veis-lzf/DC-stabilized-voltage-source/readme.md

# 便携式USB直流稳压电源

## 参数简介

1. 电压输出范围：0V~10V
2. 额定功率：5V/300mA
3. 显示精度：±0.01V

## 备注

	（1）需要更大电流输出的，可更换更大体积的电感，把USB修改为Type-C接口，续流二极管D4和保险丝F1也需要根据实际情况调整，需要注意芯片layout时散热处理；
