veis-lzf/DC-stabilized-voltage-source/PCB/SMT/Vpwr_V1.2_BOM.xlsx

Design Name G:/Cadence Allegro/My_Prj/VarPower/PCB/Vpwr_v1_2.brd |  |  |  |  |  | 器件标注说明 | NC
Date Sat Aug 30 16:28:15 2020 |  |  |  |  |  |  | SMT
Vpwr_V1.2_BOM |  |  |  |  |  |  | 后焊
封装名称 | 器件具体型号 | 元器件值 | 器件类别 | 数量 | 位号 | 是否SMT
1_25_PWT_4P |  | Download | 贴片连接座 | 1 | J1
1_25_PWT_4P |  | UART1 | 贴片连接座 | 1 | J2
C0603 |  | 1uF/10V | 贴片电容 | 1 | C1
C0603 |  | 0.1uF/50V | 贴片电容 | 3 | C2,C4,C11
C0603 |  | 1uF/16V | 贴片电容 | 2 | C3,C5
C0603 |  | 0.01uF/50V | 贴片电容 | 1 | C12
CH5R08-2A |  | B2S | 直插连接座 | 1 | J3
C_SMD_10X10_3 |  | 470uF/25V | 贴片铝电解电容 | 1 | C9
FULSE1206 |  | 1A/16V | 贴片自恢复保险 | 1 | F1
LED-SEG-TH_SLR0283DBA1BD |  | SLR0283DBA1BD | 2.8英寸三位数码管 | 1 | DS1
R0603 |  | 10K | 贴片电阻 | 3 | R1,R14,R17
R0603 |  | 100R | 贴片电阻 | 9 | R2,R3,R4,R5,R6,R7,R8,R9,R20
R0603 |  | 191K/1% | 贴片电阻 | 1 | R10
R0603 |  | 100K | 贴片电阻 | 1 | R11
R0603 |  | 10K/1% | 贴片电阻 | 1 | R12
R0603 |  | 3K | 贴片电阻 | 3 | R13,R16,R18
R0603 |  | 3K/1% | 贴片电阻 | 1 | R15
R0603 |  | 1K/1% | 贴片电阻 | 1 | R19
R0603 |  | 200R | 贴片电阻 | 2 | R21,R22
RK09K |  | 10K | 旋钮式可调电阻 | 1 | VR1
SK-12D02-VG3 |  | SPDT-SW | 拨动开关 | 1 | SW1
SM3521 |  | 4.7uH | 贴片工字电感 | 1 | L1
SOD123 |  | SS14 | 贴片肖特基二极管 | 3 | D1,D4,D5
SOD123 |  | SS14/NC | 贴片肖特基二极管 | 1 | D2
SOD323 |  | MM3Z9V1/NC | 贴片稳压管 | 1 | D3
SOIC-8 |  | LM358 | 贴片双运放 | 1 | U4
SOT-23 |  | AO3401 | 贴片PMOS管 | 1 | Q2
SOT-23 |  | MMBT5551 | 贴片NPN三级管 | 1 | Q3
SOT-23 |  | TL431ACD | 2.49V基准源 | 1 | Q4
SOT-23 |  | SC662K-3.3V | LDO降压芯片 | 1 | U2
SOT-23-6 |  | SX1308 | 升压DCDC芯片 | 1 | U3
TA3216 |  | 22uF | 贴片钽电容 | 1 | C6
TA3216 |  | 22uF/25V | 贴片钽电容 | 3 | C7,C8,C10
TO252-132 |  | 2SB772-P | 贴片PNP功率三级管 | 1 | Q1
TP-40MIL-SMT |  | VUSB_IN | 测试点 | 1 | TP1
TP-40MIL-SMT |  | VUSB | 测试点 | 1 | TP2
TP-40MIL-SMT |  | VIN_12V | 测试点 | 1 | TP3
TP-40MIL-SMT |  | VIN | 测试点 | 1 | TP4
TP-40MIL-SMT |  | VOUT | 测试点 | 1 | TP5
TP-40MIL-SMT |  | TEST_POINT | 测试点 | 1 | TP6
TP-40MIL-SMT |  | FEEDBACK | 测试点 | 1 | TP7
TSSOP-20 |  | STM8S103F3P6 | 单片机 | 1 | U1
USB-A-M-DIP |  | USB_A | USB公头 | 1 | USB1
