veis-lzf/DC-stabilized-voltage-source/PCB/ASM/ADT.dxf

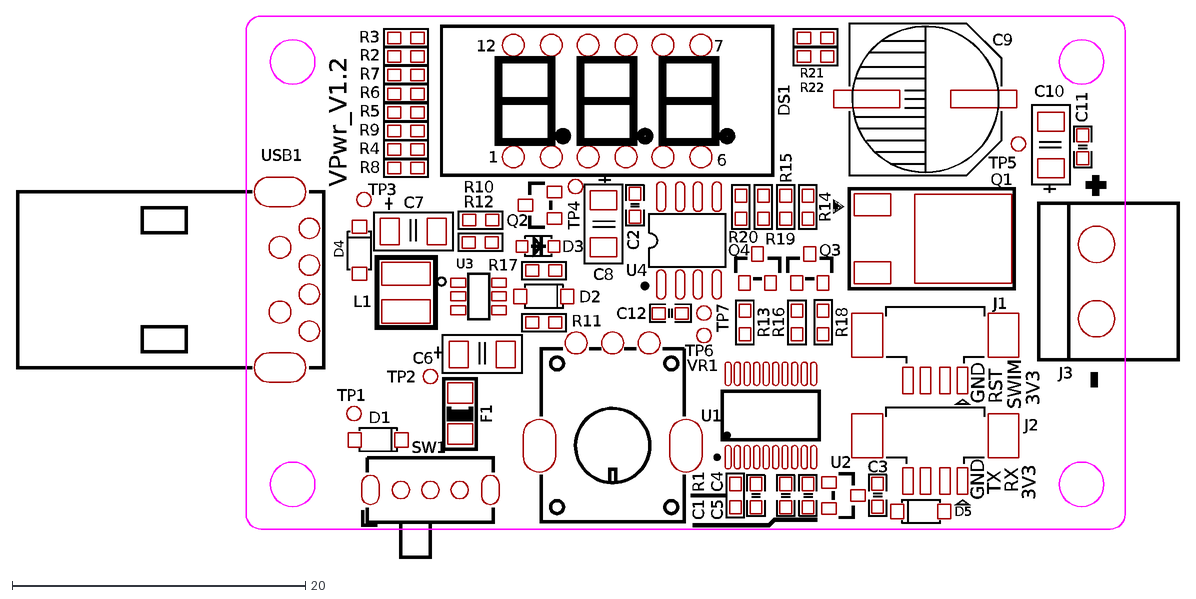
[picture p2: CAD file, 2020-08-30]
PCB/ASM/ADT.dxf
U3
J3
U1
VR1
USB1
DS1
1
6
7
12
SW1
L1
D5
D4
D2
D1
TP1
TP2
TP3
TP4
TP5
TP6
TP7
R22
R21
R12
R14
R1
R9
R8
R7
R6
R5
R4
R3
R20
R2
R19
R15
R18
R16
R13
R11
R10
R17
F1
C10
C7
C8
C6
C9
C1
C5
C11
C2
C4
C12
C3
D3
Q1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
