veis-lzf/DC-stabilized-voltage-source/PCB/ASM/ADB.dxf

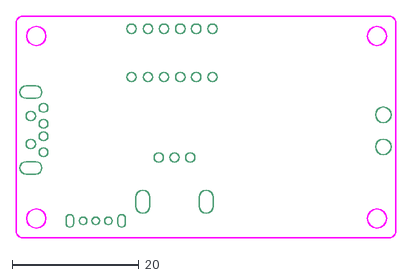
[picture p3: CAD file, 2020-08-30]
PCB/ASM/ADB.dxf
60.0 x 35.0
