veis-lzf/DC-stabilized-voltage-source/(list of files, cad)

Other CAD files:
PCB/ASM/测试点标注图.dwg
