veis-lzf/DC-stabilized-voltage-source/SCH/Vpwr_V1_2_SCH.pdf

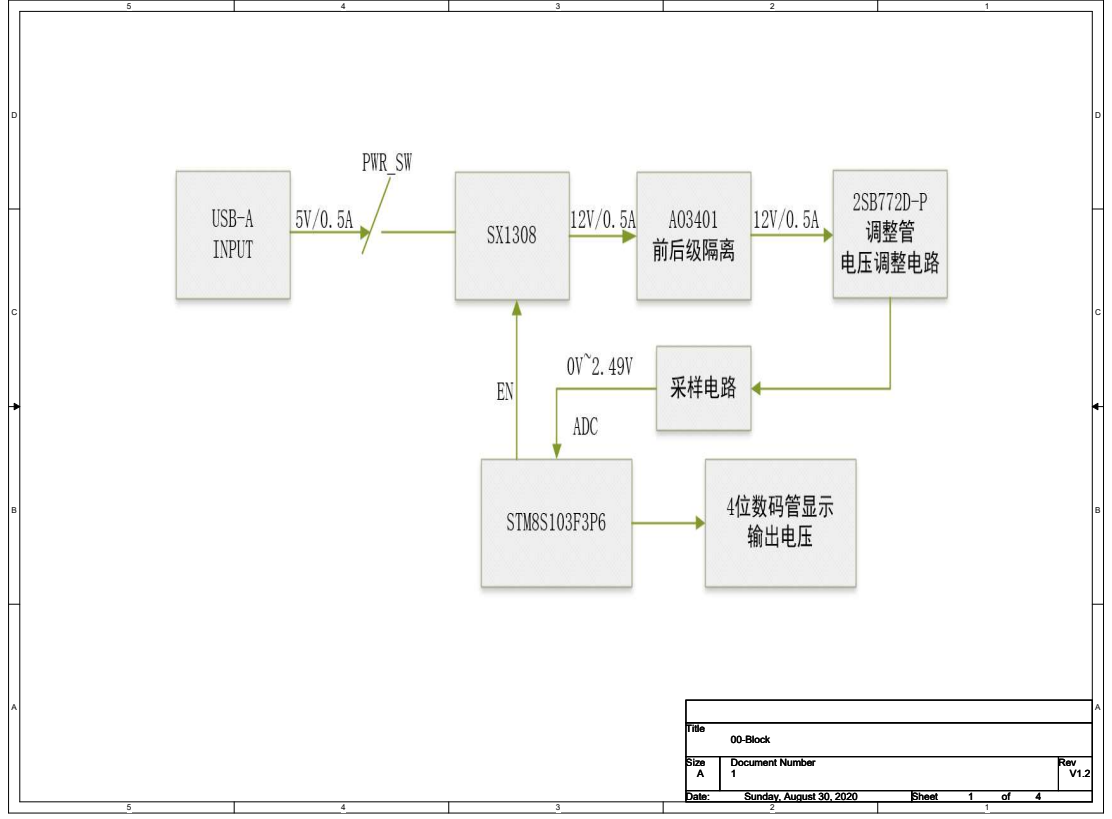
[picture p4: page 1]
A A Title; Size; Document Number; Rev; Date:; Sheet; 00-Block; Sunday, August 30, 2020; Title

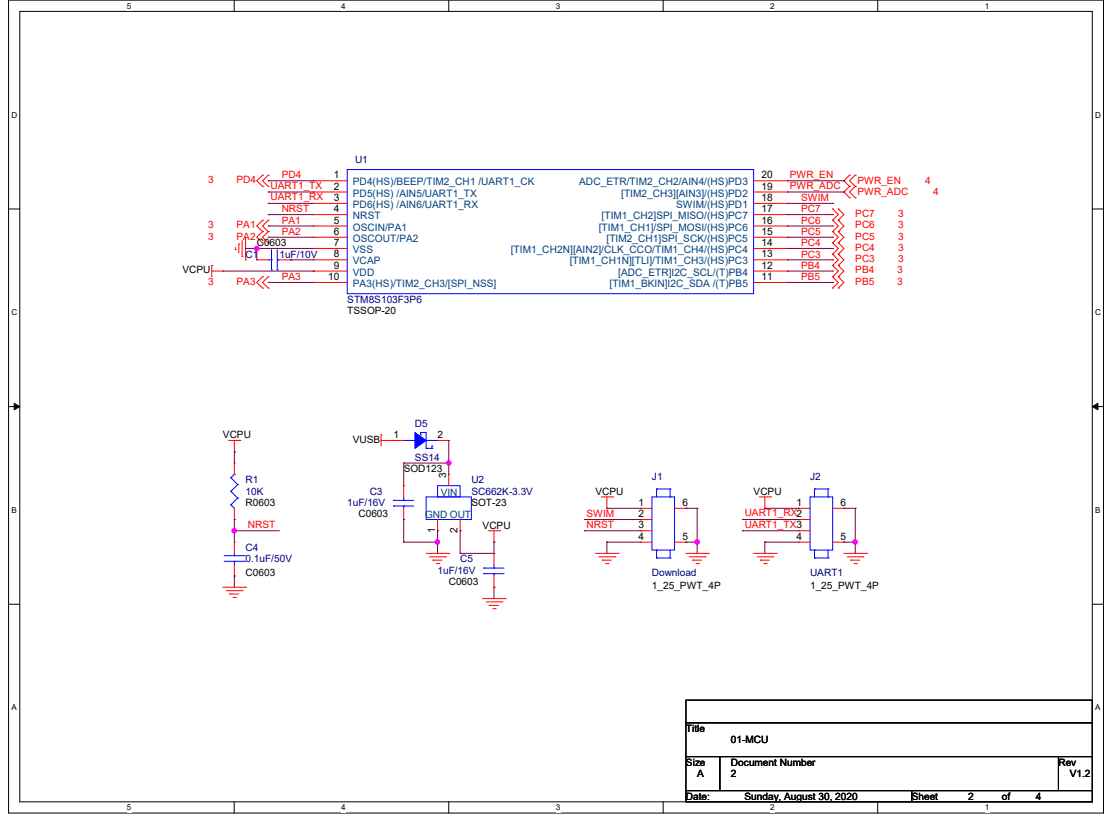
[picture p5: page 2]

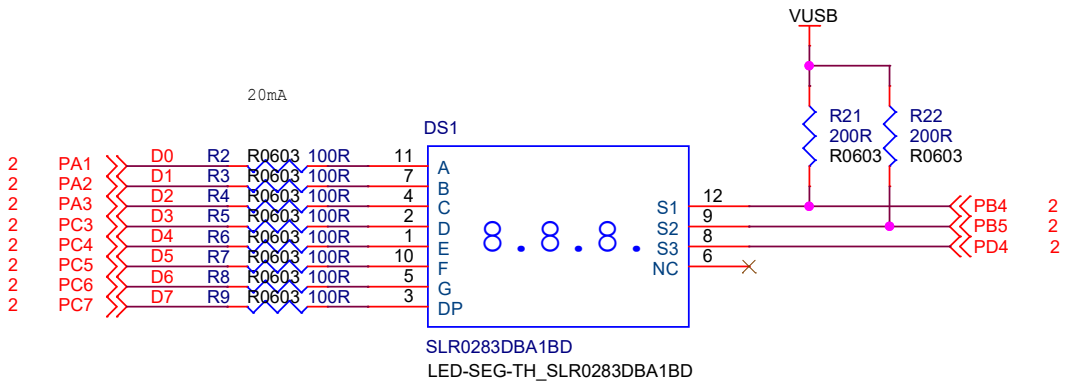
[picture p6: page 3]

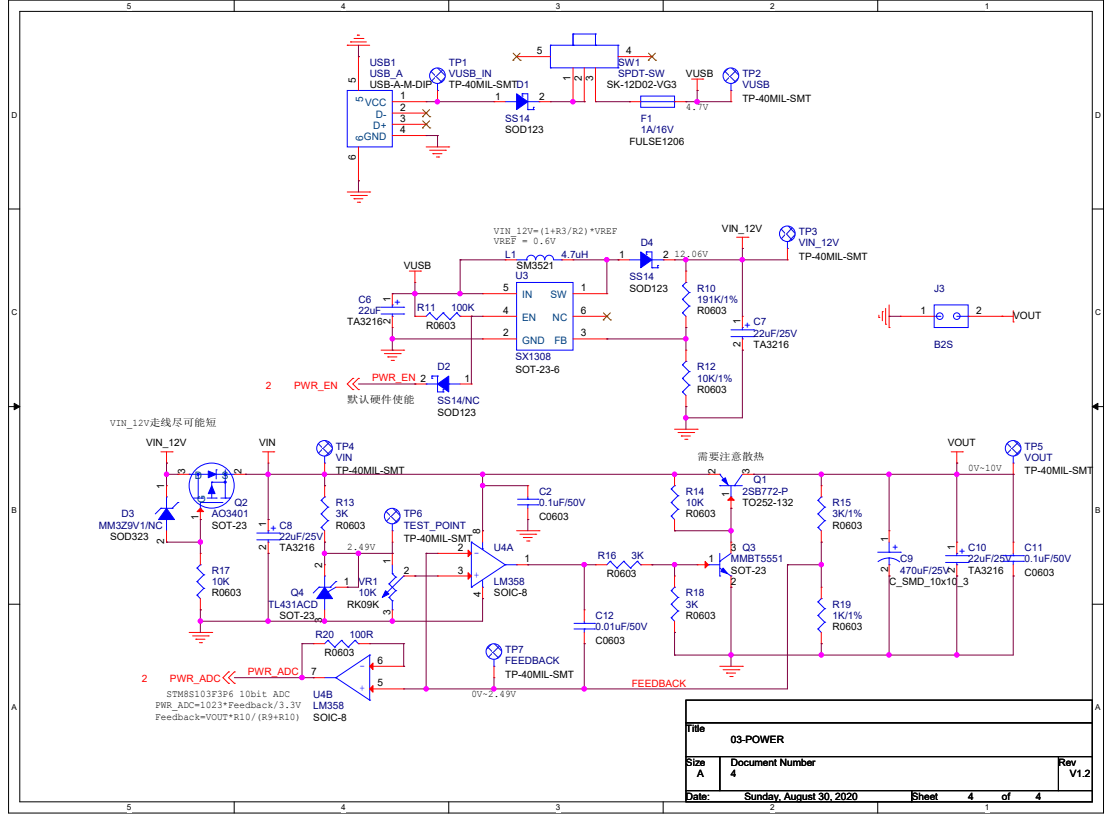
[picture p7: page 4]
