veis-lzf/DC-stabilized-voltage-source/PCB/ASM/测试点标注图.pdf

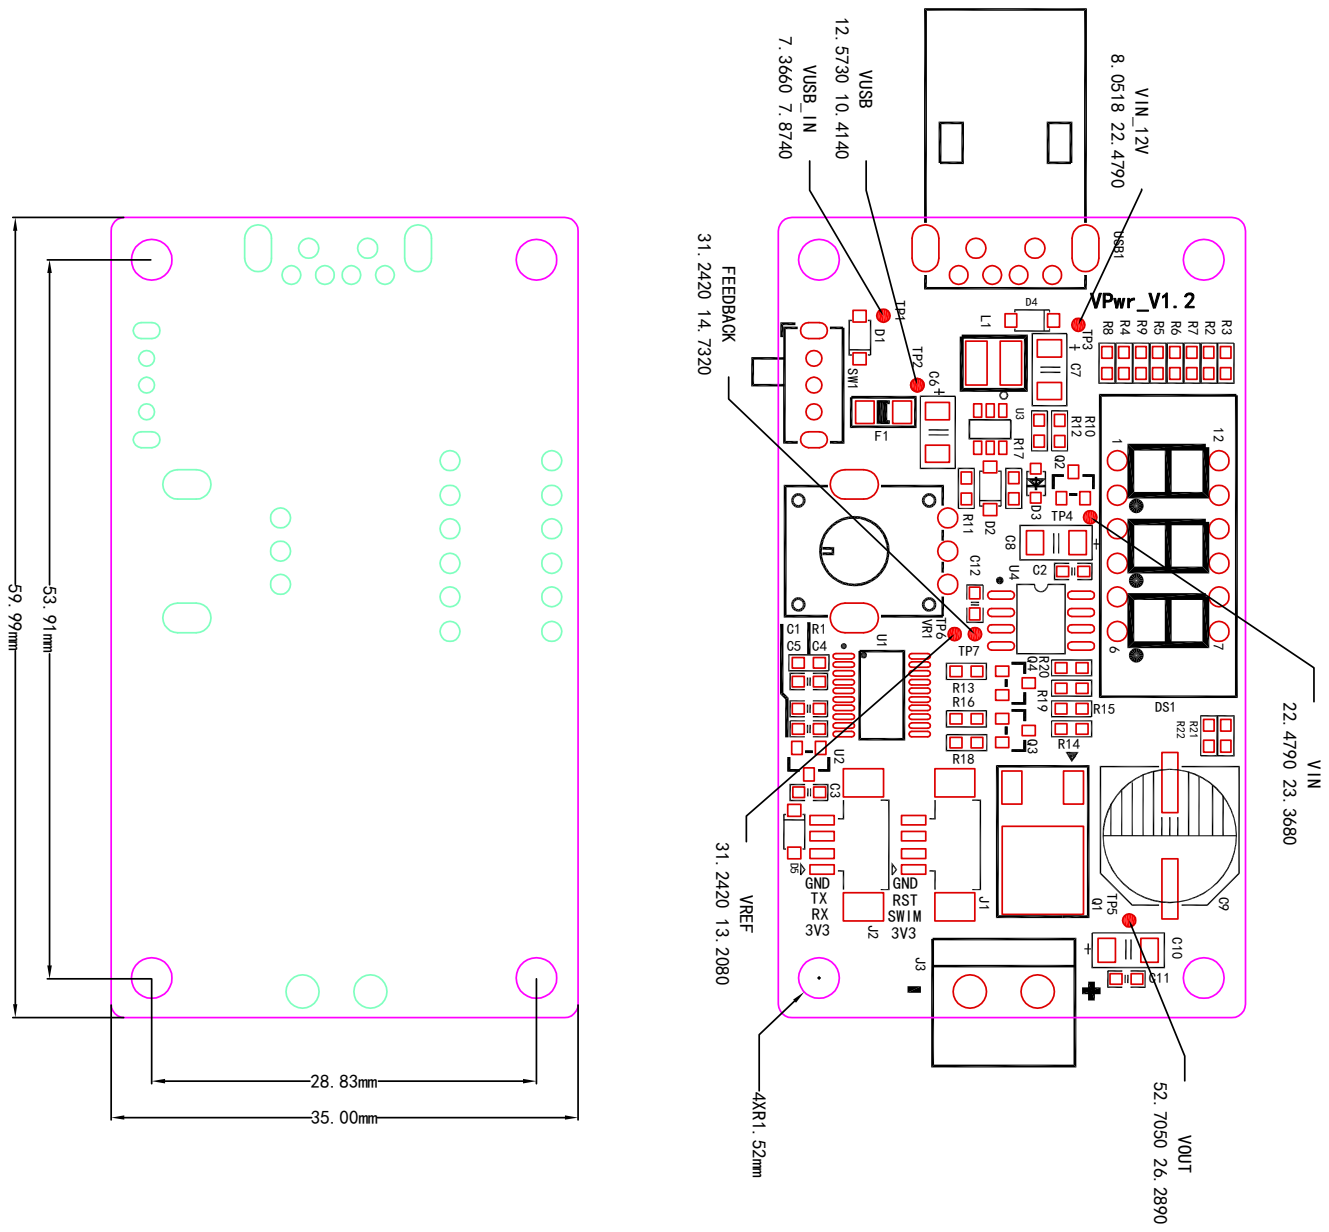
[picture p8: page 1]
