veis-lzf/DC-stabilized-voltage-source/(list of files, drawings)

Other design files:
SCH/VPWR.DSN
SCH/VPwr.opj
