veis-lzf/DC-stabilized-voltage-source/(commit log)

2020-08-30 '直流可调电源文件整理'
    [ADB.dxf, ADT.dxf, VPWR.DSN, VPwr.opj, Vpwr_V1.2_BOM.xlsx, Vpwr_v1_2.brd, art_param.txt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]
2020-08-30 '上传代码文件'
2020-08-30 增加readme说明文件
2020-08-30 删除原理图文件
2020-08-30 删除PCB文件夹下DXF临时文件
2020-08-30 删除代码文件中产生的log日志
2020-08-30 移除版本变更说明文件，后续更新转移到readme.md中
2020-08-30 增加备注说明（4）
2020-08-30 修改readme文件
